FrancoGomez-98/Trabajo_Practico_Integrador-Fundamentos_de_Robotica/(commit log)

2026-06-28 Create Firmware
    Código fuente ejecutable para el ESP32.
2026-06-28 Código fuente ejecutable para el ESP32.
2026-06-28 Guía técnica principal de presentación
2026-06-28 Guía técnica principal de presentación.
